vlvassilev/powermod-54260/(list of files, drawings)

Other design files:
simulation/TPS54260_PSPICE_TRANS/TPS54260_TRANS.DSN
simulation/TPS54260_PSPICE_TRANS/TPS54260_TRANS.OLB
simulation/TPS54260_PSPICE_TRANS/tps54260_trans.opj
