vlvassilev/powermod-54260/(commit log)

2022-01-26 Release powermod-2-1
    [powermod-bom.csv, powermod.sch]
2022-08-11 Release powermod-2-2
    [powermod.kicad_pcb]
2022-08-11 Release powermod-tps54202-1.0
    [bom.csv, powermod-bom.csv, powermod.kicad_pcb, powermod.sch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]
2022-12-31 Release powermod-tps54202-1.1
    [bom.csv, powermod.kicad_pcb, powermod.sch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]
2022-12-31 Release powermod-tps54202-1.2
    [powermod.kicad_pcb, powermod.kicad_sch, powermod.sch]
2023-01-02 Release powermod-tps54202-1.3
    [bom.csv, powermod.kicad_pcb, powermod.kicad_sch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]
2023-09-25 Release powermod-tps54202-2.0
    [powermod.kicad_pcb, powermod.kicad_sch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]
2023-10-03 Release powermod-tps54202-3.0
    [bom.csv, powermod.kicad_pcb, powermod.kicad_sch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]
2024-08-02 feat: tps54260
    [powermod-attempt-1.kicad_pcb, powermod.kicad_pcb]
2024-08-02 feat: finished rev 1
    [powermod.kicad_pcb]
2024-08-02 feat: cleaned up refrences
    [powermod.kicad_pcb]
2024-08-02 feat: added arrow
    [powermod.kicad_pcb]
2024-08-02 feat: saved schematic
    [powermod.kicad_sch]
2024-08-02 fix: moved and fixed cap footprint
    [bom.csv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]
2024-08-02 feat: powermod-tps54260-1.0-1 production files
    [powermod-B_Adhesive.gbr, powermod-B_Courtyard.gbr, powermod-B_Cu.gbr, powermod-B_Fab.gbr, powermod-B_Mask.gbr, powermod-B_Paste.gbr, powermod-B_Silkscreen.gbr, powermod-Edge_Cuts.gbr]
2024-08-02 fix: better resistor values
    [powermod.kicad_pcb, powermod.kicad_sch]
2024-08-02 feat: big capacitor
    [powermod.kicad_pcb, powermod.kicad_sch]
2024-08-02 feat: labeling
    [powermod.kicad_pcb]
2024-08-02 feat: changes
    [powermod.kicad_pcb]
2024-08-11 fix: now delivers 1.5 amps
    [bom.csv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]
2024-08-11 fix: 100uf
    [powermod.kicad_sch]
2024-08-19 feat: added simulation
    [TPS54260_TRANS.DSN, TPS54260_TRANS.OLB, tps54260_trans.opj]
